devikanambiar05/buck_converter_pcb/Buck converter.kicad_pcb

## KiCad design Buck converter.kicad_pcb (2026-10-23)

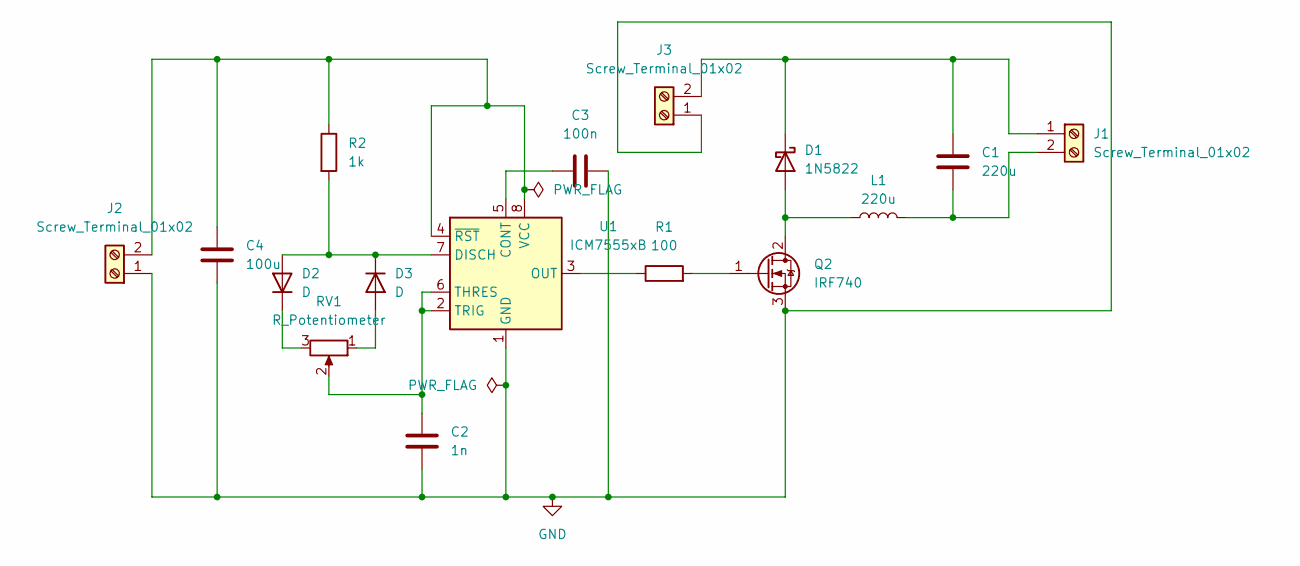
[picture p1: schematic Buck converter.kicad_sch]

Parts:
C1: 220u; CP_Radial_D8.0mm_P3.50mm
C2: 1n; C_Disc_D5.0mm_W2.5mm_P5.00mm
C3: 100n; C_Disc_D5.0mm_W2.5mm_P5.00mm
C4: 100u; CP_Radial_D8.0mm_P3.50mm
D1: 1N5822; D_DO-201AD_P15.24mm_Horizontal
D2, D3: D; D_DO-35_SOD27_P7.62mm_Horizontal
J1, J2, J3: Screw_Terminal_01x02; TerminalBlock_Phoenix_MKDS-1,5-2-5.08_1x02_P5.08mm_Horizont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
L1: 220u; L_Radial_D12.0mm_P5.00mm_Fastron_11P
Q2: IRF740; TO-220-3_Vertical
R1: 100; R_Axial_DIN0207_L6.3mm_D2.5mm_P7.62mm_Horizontal
R2: 1k; R_Axial_DIN0207_L6.3mm_D2.5mm_P7.62mm_Horizontal
RV1: R_Potentiometer; Potentiometer_Bourns_3296W_Vertical
U1: ICM7555xB; DIP-8_W7.62mm

Connections:
GND: C2.2, C3.2, C4.2, J2.1, J3.1, Q2.3 (S), U1.1 (GND)
unnamed: D1.2 (A), L1.1, Q2.2 (D)
unnamed: C1.1, D1.1 (K), J1.1, J3.2
unnamed: D2.2 (A), D3.1 (K), R2.2, U1.7 (DISCH)
unnamed: D2.1 (K), RV1.3
unnamed: D3.2 (A), RV1.1
unnamed: C1.2, J1.2, L1.2
unnamed: C4.1, J2.2, R2.1, U1.4 (~RST), U1.8 (VCC)
unnamed: Q2.1 (G), R1.2
unnamed: C3.1, U1.5 (CONT)
unnamed: R1.1, U1.3 (OUT)
unnamed: C2.1, RV1.2, U1.2 (TRIG), U1.6 (THRES)

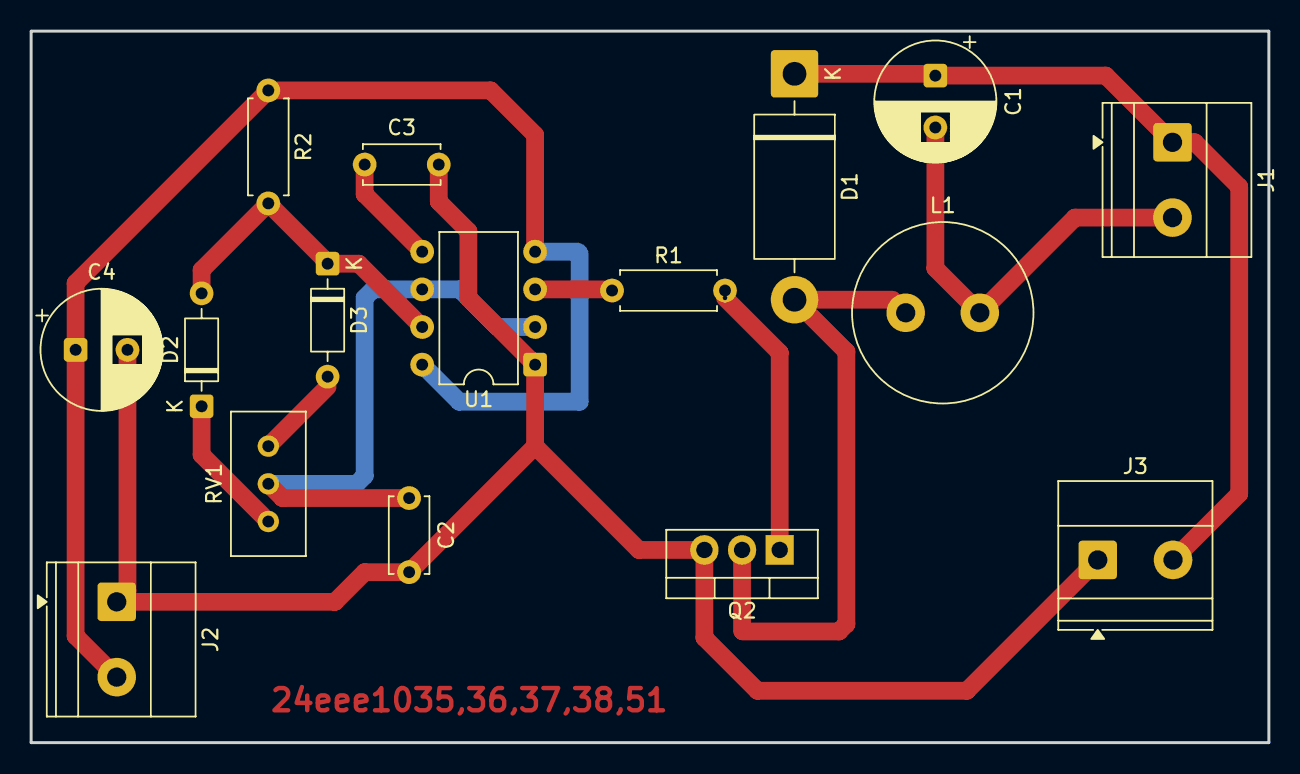
[picture p2: board Buck converter.kicad_pcb from above]

Board: 2 copper layers, 83.5 x 48.0 mm, 16 parts (0 on the bottom side), 12 nets.
