devikanambiar05/buck_converter_pcb/(commit log)

2026-10-23 Initial commit: 555 timer based buck converter
    [Buck converter-B_Cu.gbr, Buck converter-B_Mask.gbr, Buck converter-B_Paste.gbr, Buck converter-B_Silkscreen.gbr, Buck converter-Edge_Cuts.gbr, Buck converter-F_Cu.gbr, Buck converter-F_Mask.gbr, Buck converter-F_Paste.gbr]
2026-10-23 Create README for 555-Based Low-Side Buck Converter
    Add detailed documentation for 555-based low-side buck converter, including circuit overview, design journey, bill of materials, and safety notes.
